AlejandroAriza12/uPMU-Alejandro-Ariza-Laura-Sofia-Rico-/BOM_y_reglas.xlsx

Sheet: BOM
Lista de componentes (BOM) — shield µPMU v5 (una capa)
Valores del montaje validado en protoboard (Rb = 100 Ω, Rf = 30 kΩ, Rg = 10 kΩ, G = 4).
Referencia | Cant. | Valor | Descripción | Encapsulado | Función | Nota
R1, R2, R6, R7 | 4 | 10 kΩ | Resistencia ¼ W, película metálica 1 % | Axial, paso 10,16 mm | R1/R2: divisor de V_B · R6: Rg · R7: divisor del ZMPT | Marrón-negro-negro-rojo (1 %) o marrón-negro-naranja (5 %)
R5 | 1 | 30 kΩ | Resistencia ¼ W, película metálica 1 % | Axial, paso 10,16 mm | Rf, realimentación (G = 1 + 30k/10k = 4) | Naranja-negro-negro-rojo (1 %)
R8 | 1 | 20 kΩ | Resistencia ¼ W, película metálica 1 % | Axial, paso 10,16 mm | Divisor del ZMPT (factor 2/3) | Rojo-negro-negro-rojo (1 %)
R4 | 1 | 100 Ω | Resistencia ¼ W, película metálica 1 % | Axial, paso 10,16 mm | Rb, carga del SCT-013-000 | Marrón-negro-negro-negro (1 %)
R3 | 1 | 1 kΩ | Resistencia ¼ W | Axial, paso 10,16 mm | Protección de la entrada PA0 | Marrón-negro-negro-marrón (1 %)
C1, C2, C4 | 3 | 10 µF | Electrolítico ≥ 16 V | Radial Ø5 mm, paso 2,5 mm | C1: filtro V_B · C2: Cg · C4: filtro de 5 V | Polarizado: la pata larga (+) va al cuadrado marcado +
C3 | 1 | 100 nF | Cerámico (código 104) | Disco, paso 5 mm | Desacople del LM358 (pin 8) | Si no tienes, 10 nF (103) funciona como en la protoboard
C5, C6 | 2 | 1 nF | Cerámico (código 102) | Disco, paso 5 mm | OPCIONAL: filtro en PA0 y PA4 | Sin ellos el circuito queda igual al validado
U1 | 1 | LM358N | Amplificador operacional doble | DIP-8 | v3: canal de corriente en la mitad B (pines 5, 6, 7) y seguidor de V_B en la A (1, 2, 3) | Muesca hacia el Nucleo (pin 1 = pad cuadrado, arriba a la izquierda)
— | 1 | Zócalo DIP-8 | Base para circuito integrado | DIP-8, 7,62 mm | Para poder cambiar el LM358 sin desoldar
J5, J6 | 2 | Tira hembra 1x15 | Conector hembra 2,54 mm | 1x15 vertical | Zócalos donde se enchufa el Nucleo-F303K8 | Separación entre filas 15,24 mm
J1 | 1 | Espadín macho 1x2 | Conector 2,54 mm | 1x2 vertical | Entrada del SCT (S = manga, T = punta) | Cablear desde el jack SJ1-355xNG: pin 1 → S, pin 2 → T
J2 | 1 | Espadín macho 1x4 | Conector 2,54 mm | 1x4 vertical | Módulo ZMPT: VCC, OUT, GND, GND (mismo orden que el espadín del módulo) | Cable Dupont hembra-hembra de 4 hilos
W1, W2 | 2 | Alambre desnudo | Puente de alambre (calibre 22–24 AWG, o una pata cortada de resistencia) | W1 ≈ 12 mm, W2 = 9 mm | Une partes del plano de GND (la placa es de una capa) | Va por el lado de componentes, de pad a pad
J3, J4 | 2 | Espadín macho 1x5 | Conector 2,54 mm | 1x5 vertical | J3: GPS (PPS, RX, TX, GND, VCC de arriba abajo) · J4: prueba (AV, GND, AI, IOUT, VB) | Revisa el orden en la serigrafía antes de cablear
H1–H4 | 4 | Tornillo M3 + separador | Montaje | Agujero 3,2 mm con fiducia rellena de 4,8 mm (cobre, máscara y serigrafía) | Opcional; los huecos sirven de fiducias para alinear cobre y serigrafía
Fuera de la placa | 1 | SCT-013-000 con jack 3,5 mm | Sensor de corriente 100 A : 50 mA | — | Se conecta a J1
Fuera de la placa | 1 | Módulo ZMPT101B | Sensor de tensión (módulo azul) | — | 120 V solo en su bornera (L, N); VCC/OUT/GND/GND a J2 | Con limitador interno; ver nota de seguridad
Fuera de la placa | 1 | GPS NEO-7M | Módulo GPS con salida PPS | — | Se conecta a J3
Fuera de la placa | 1 | Nucleo-F303K8 | Microcontrolador STM32F303K8 | Nucleo-32 | Se enchufa en J5 y J6

Sheet: Pines Nucleo
Conexiones al Nucleo-F303K8
Pin 1 de cada tira = extremo CERCA del USB. En la v3, v4 y v5 el USB del Nucleo queda hacia ARRIBA (borde superior de la placa).
Conector | Pin | Nombre en el Nucleo | Red | Qué es | Va a
CN4 (J6) | 1 | VIN | — sin conexión
CN4 (J6) | 2 | GND | GND | Tierra común | R2.2, C1.2, U1.4, C2.2, C5.2, C3.2, C4.2, J2.3, J2.4, R8.2, C6.2, J3.2, W1.1, W1.2, W2.1, W2.2, J4.2
CN4 (J6) | 3 | NRST | — sin conexión
CN4 (J6) | 4 | +5V | +5V | 5 V del Nucleo (pin 5V) | U1.8, C3.1, C4.1, J2.1
CN4 (J6) | 5 | A7/PA2 | — sin conexión
CN4 (J6) | 6 | A6/PA7 | — sin conexión
CN4 (J6) | 7 | A5/PA6 | — sin conexión
CN4 (J6) | 8 | A4/PA5 | — sin conexión
CN4 (J6) | 9 | A3/PA4 | ADC_V | Señal de tensión a PA4 (A3) | R7.2, R8.1, C6.1, J4.1
CN4 (J6) | 10 | A2/PA3 | — sin conexión
CN4 (J6) | 11 | A1/PA1 | PPS | PPS del GPS → PA1 (A1) | J3.5
CN4 (J6) | 12 | A0/PA0 | ADC_I | Señal de corriente a PA0 (A0) | R3.2, C5.1, J4.3
CN4 (J6) | 13 | AREF | — sin conexión
CN4 (J6) | 14 | +3V3 | +3V3 | 3,3 V del Nucleo | R1.1, J3.1
CN4 (J6) | 15 | D13/PB3 | — sin conexión
CN3 (J5) | 1 | D1/PA9 | GPS_RX | PA9 (D1) → RX del GPS | J3.4
CN3 (J5) | 2 | D0/PA10 | GPS_TX | TX del GPS → PA10 (D0) | J3.3
CN3 (J5) | 3 | NRST | — sin conexión
CN3 (J5) | 4 | GND | GND | Tierra común | R2.2, C1.2, U1.4, C2.2, C5.2, C3.2, C4.2, J2.3, J2.4, R8.2, C6.2, J3.2, W1.1, W1.2, W2.1, W2.2, J4.2
CN3 (J5) | 5 | D2/PA12 | — sin conexión
CN3 (J5) | 6 | D3/PB0 | — sin conexión
CN3 (J5) | 7 | D4/PB7 | — sin conexión
CN3 (J5) | 8 | D5/PB6 | — sin conexión
CN3 (J5) | 9 | D6/PB1 | — sin conexión
CN3 (J5) | 10 | D7/PF0 | — sin conexión
CN3 (J5) | 11 | D8/PF1 | — sin conexión
CN3 (J5) | 12 | D9/PA8 | — sin conexión
CN3 (J5) | 13 | D10/PA11 | — sin conexión
CN3 (J5) | 14 | D11/PB5 | — sin conexión
CN3 (J5) | 15 | D12/PB4 | — sin conexión

Sheet: Redes
Lista de redes (netlist)
Cada fila: todos los pines que deben quedar unidos. Formato REF.pin (por ejemplo U1.3 = pin 3 del LM358).
Red | Qué es | Pines unidos
+5V | 5 V del Nucleo (pin 5V) | C3.1, C4.1, J2.1, J6.4, U1.8
+3V3 | 3,3 V del Nucleo | J3.1, J6.14, R1.1
GND | Tierra común | C1.2, C2.2, C3.2, C4.2, C5.2, C6.2, J2.3, J2.4, J3.2, J4.2, J5.4, J6.2, R2.2, R8.2, U1.4, W1.1, W1.2, W2.1, W2.2
VB | Referencia 1,65 V (centro del SCT) | C1.1, J1.1, J4.5, R1.2, R2.1, R4.2, U1.3
SCT_P | Punta del SCT / entrada + del LM358 (pin 5) | J1.2, R4.1, U1.5
FB | Entrada − del LM358 (pin 6; Rf, Rg) | R5.2, R6.1, U1.6
CG | Unión Rg–Cg | C2.1, R6.2
I_OUT | Salida del LM358 (pin 7) | J4.4, R3.1, R5.1, U1.7
ADC_I | Señal de corriente a PA0 (A0) | C5.1, J4.3, J6.12, R3.2
VB_BUF | Seguidor de V_B (pines 1 y 2) | U1.1, U1.2
ZMPT_OUT | Salida del módulo ZMPT | J2.2, R7.1
ADC_V | Señal de tensión a PA4 (A3) | C6.1, J4.1, J6.9, R7.2, R8.1
GPS_TX | TX del GPS → PA10 (D0) | J3.3, J5.2
GPS_RX | PA9 (D1) → RX del GPS | J3.4, J5.1
PPS | PPS del GPS → PA1 (A1) | J3.5, J6.11

Sheet: Reglas de diseño
Reglas de diseño declaradas en KiCad (upmu_shield.kicad_dru)
LCFI = mínimo del laboratorio (plantilla KiCad/Eagle 11-2022). Nuestra = lo que exige el DRC del proyecto (con holgura).
Regla | Mínimo LCFI (mm) | Nuestra (mm) | Holgura | Nota
Ancho mínimo de pista | 0.254 | 0.6 | +136 % | se usan 0,8 (señal) y 1,2 (5 V, 3,3 V y GND)
Separación cobre-cobre (pistas, plano) | 0.3 | 0.6 | +100 % | el doble del mínimo
Separación pad-pad del mismo conector | 0.5 | 0.5 | igual (geometría fija) | fijada por el paso de 2,54 mm; lo real es ≥ 0,54 mm
Anillo de cobre alrededor del taladro | 0.5 | 0.5 | igual (geometría fija) | real: 0,55 a 0,8 mm (conectores 0,5 en el sentido de la fila)
Taladro a cobre de otra red | 0.33 | 0.6 | +82 %
Taladro a taladro | 0.5 | 1 | +100 %
Diámetro mínimo de taladro | 0.6 | 0.8 | +33 % | 0,8 componentes, 1,0 conectores, 3,2 montaje
Cobre al borde de la placa | 0.5 | 1.5 | +200 %
Separación del plano de GND | 0.508 | 0.8 | +57 %
